PLEB666/Co2-Meter/docs/case_v4_back.png

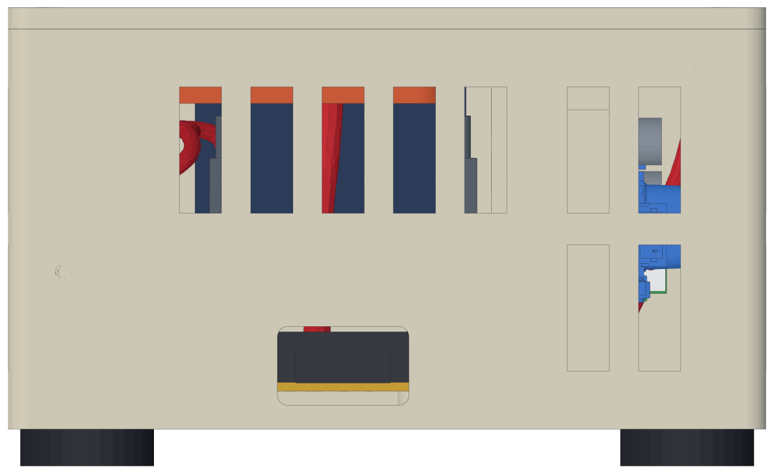
docs/case_v4_back.png
