PLEB666/Co2-Meter/docs/case_v4_back_open.png

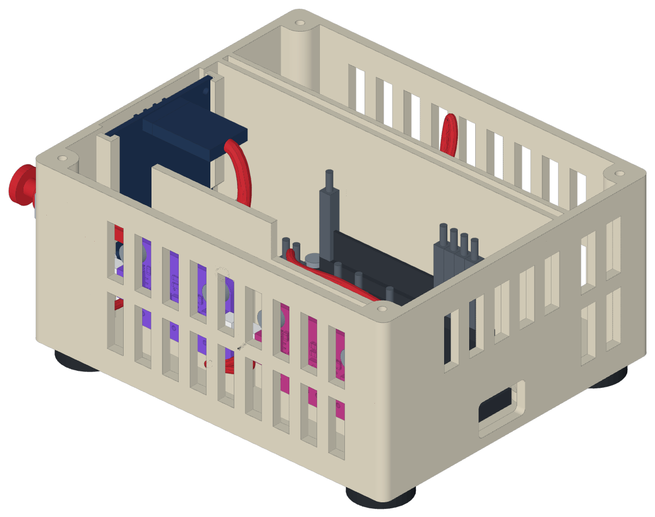
docs/case_v4_back_open.png
