PLEB666/Co2-Meter/docs/case_v4_cut.png

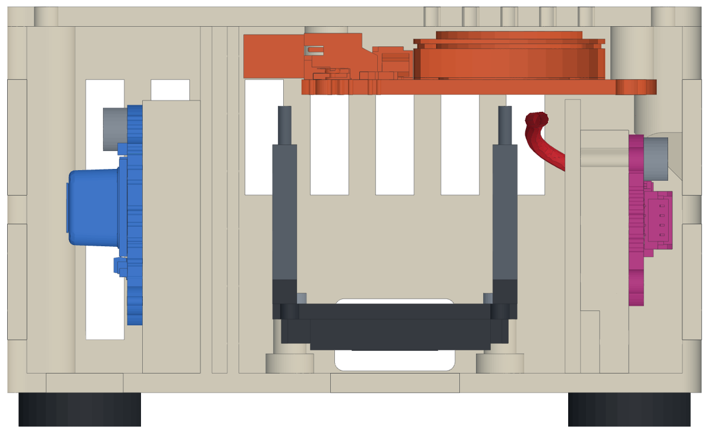
docs/case_v4_cut.png
