PLEB666/Co2-Meter/docs/case_v4_iso.png

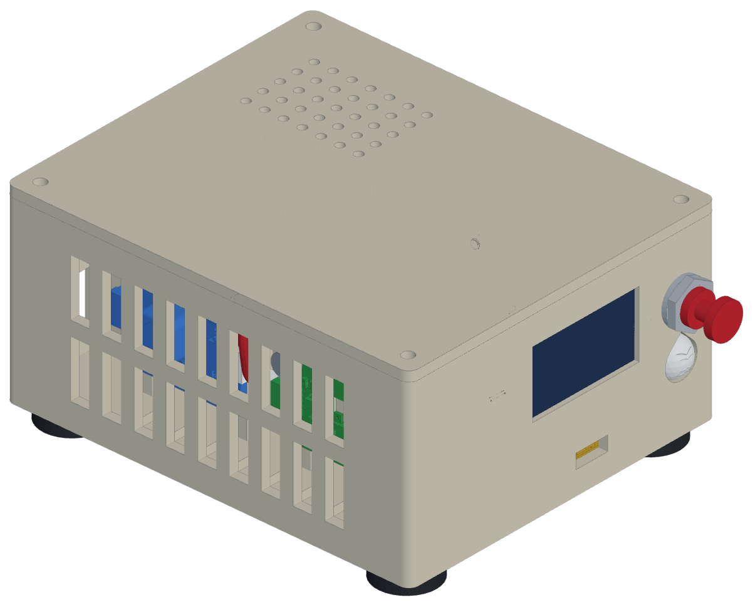
docs/case_v4_iso.png
