PLEB666/Co2-Meter/docs/case_v4_top.png

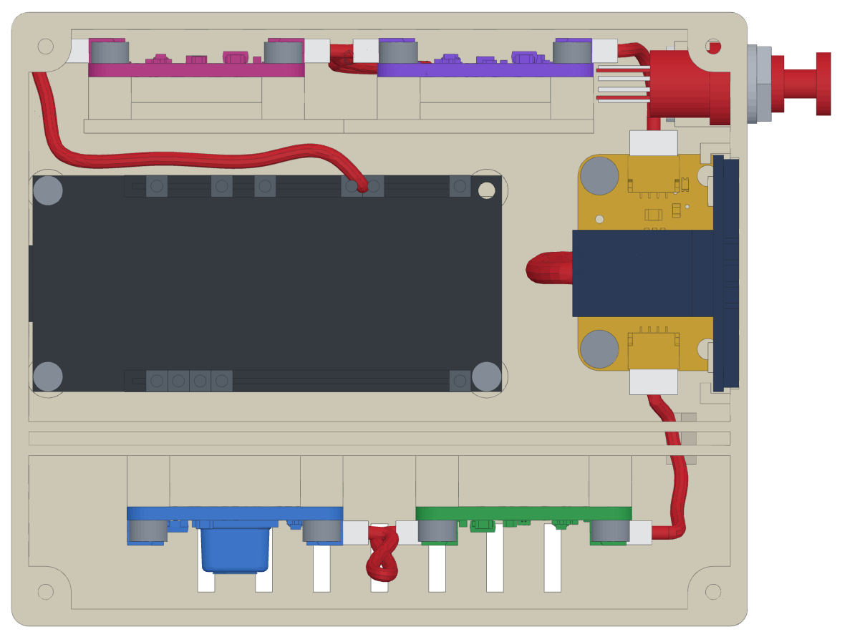
docs/case_v4_top.png
