PLEB666/Co2-Meter/docs/case_v5_front.png

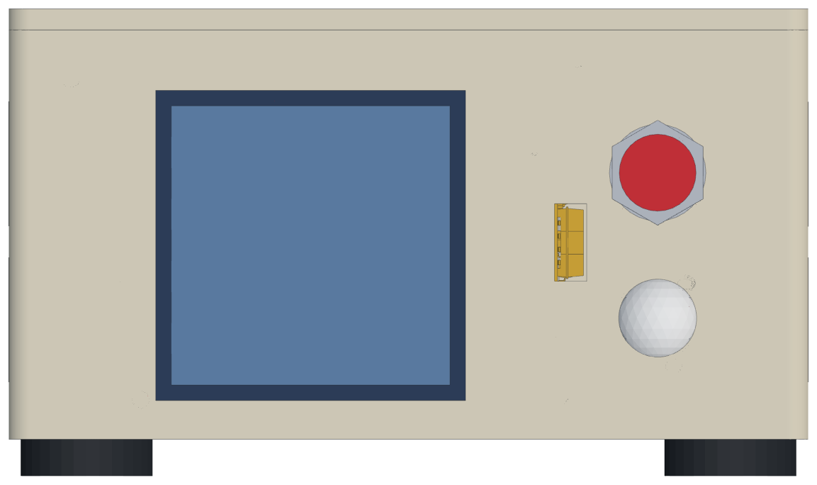
docs/case_v5_front.png
