PLEB666/Co2-Meter/docs/case_v5_iso.png

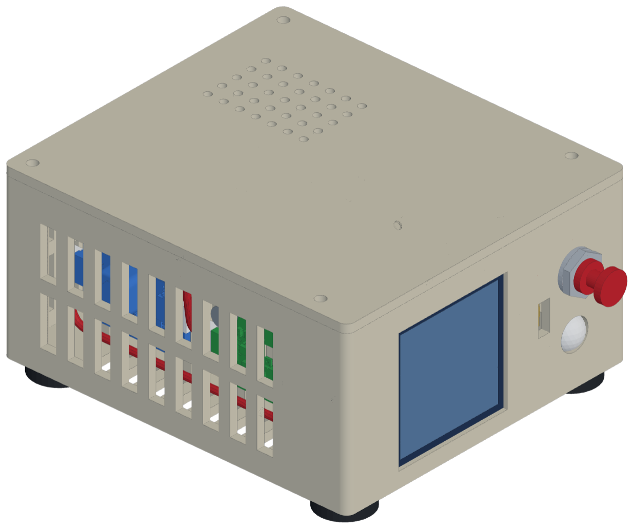
docs/case_v5_iso.png
