PLEB666/Co2-Meter/docs/web_page.png

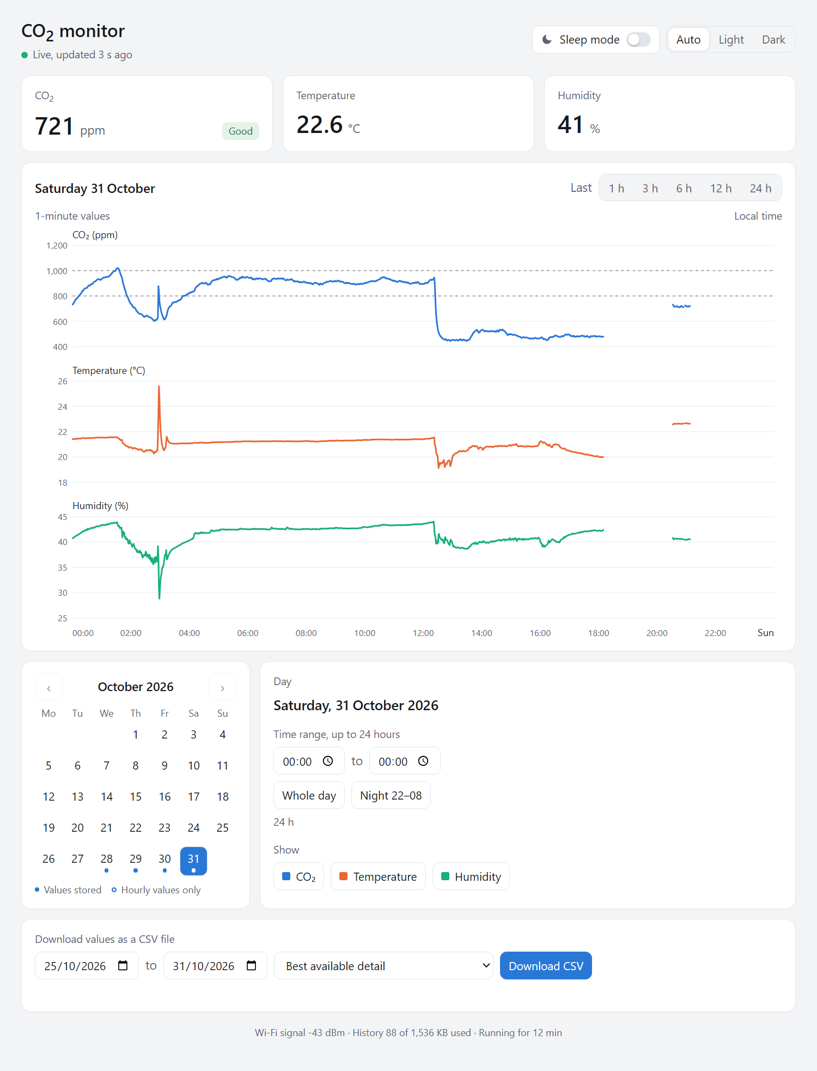
docs/web_page.png
