PLEB666/Co2-Meter/cad/adafruit/4829 SGP40 Sensor.step

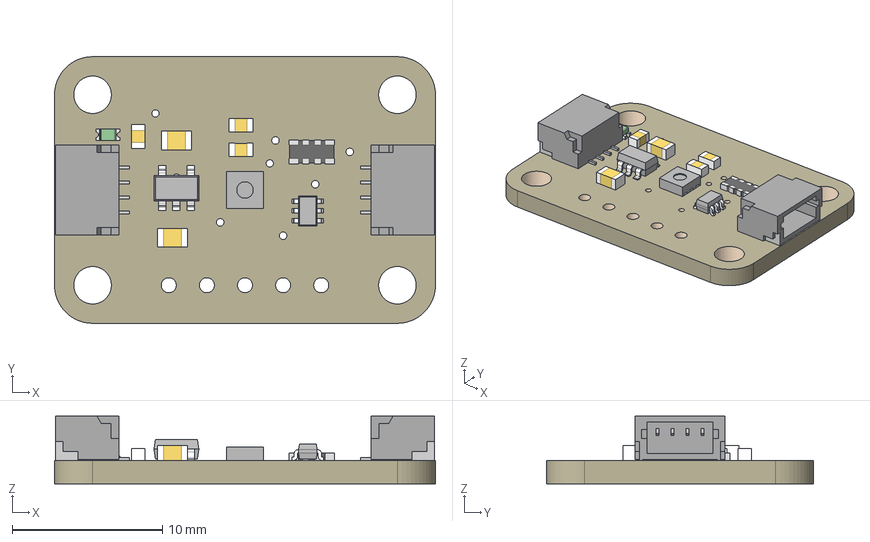
[picture p21: CAD file, 2026-11-03]
cad/adafruit/4829 SGP40 Sensor.step
25.4 x 17.8 x 4.53 mm
Board
SGP40
10uF x 2
AP2112-3.3K
4.7ohm x 3
10K
BSS138
STEMMA_I2C_QT x 2
Green
