PLEB666/Co2-Meter/cad/out/v5/esp32.stl

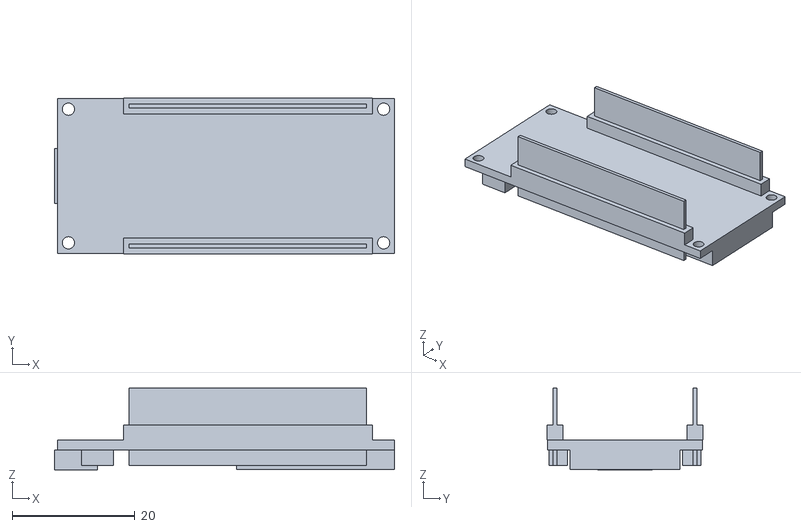
[picture p22: CAD file, 2026-11-07]
cad/out/v5/esp32.stl
55.5 x 25.4 x 13.4
