PLEB666/Co2-Meter/cad/out/v5/test_pieces/esp32_floor_no_drill.stl

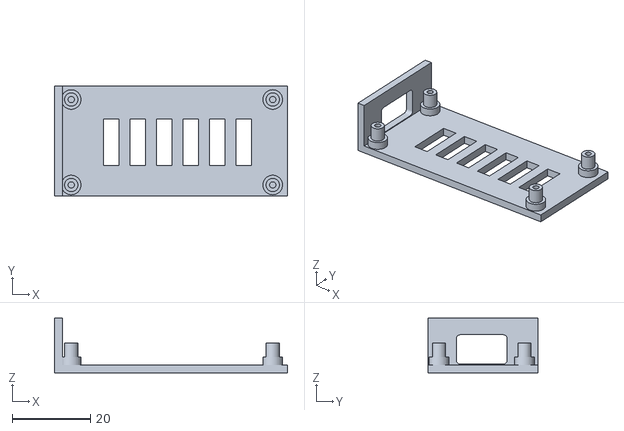
[picture p23: CAD file, 2026-11-07]
cad/out/v5/test_pieces/esp32_floor_no_drill.stl
59.5 x 28.0 x 14.0
