PLEB666/Co2-Meter/cad/adafruit/5187 SCD-40 C02 Sensor.step

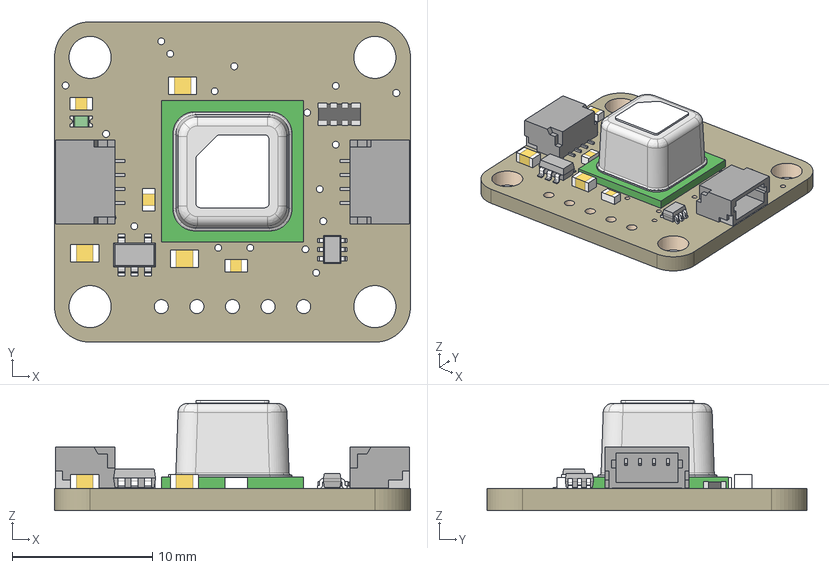
[picture p24: CAD file, 2026-11-01]
cad/adafruit/5187 SCD-40 C02 Sensor.step
25.4 x 22.9 x 7.88 mm
Board
10uF x 3
AP2112K-3.3
0.1uF x 3
10K
BSS138
STEMMA_I2C_QT x 2
GREEN
SCD-41
