PLEB666/Co2-Meter/cad/out/v5/lid.step

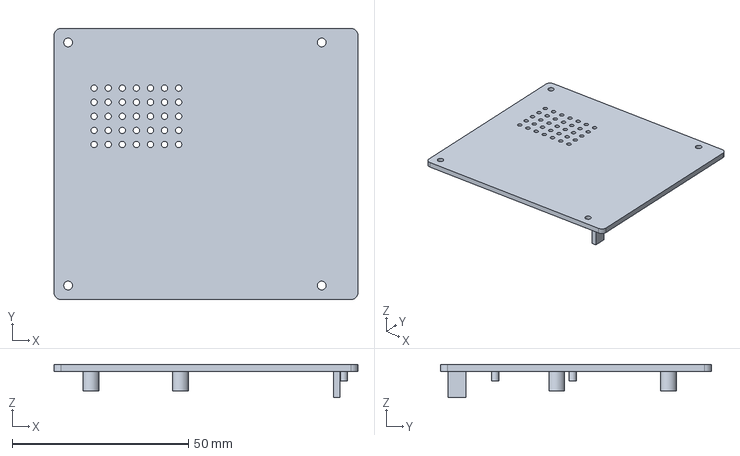
[picture p25: CAD file, 2026-11-07]
cad/out/v5/lid.step
86.3 x 77.0 x 9.44 mm
