PLEB666/Co2-Meter/cad/out/v5/test_pieces/esp32_floor.stl

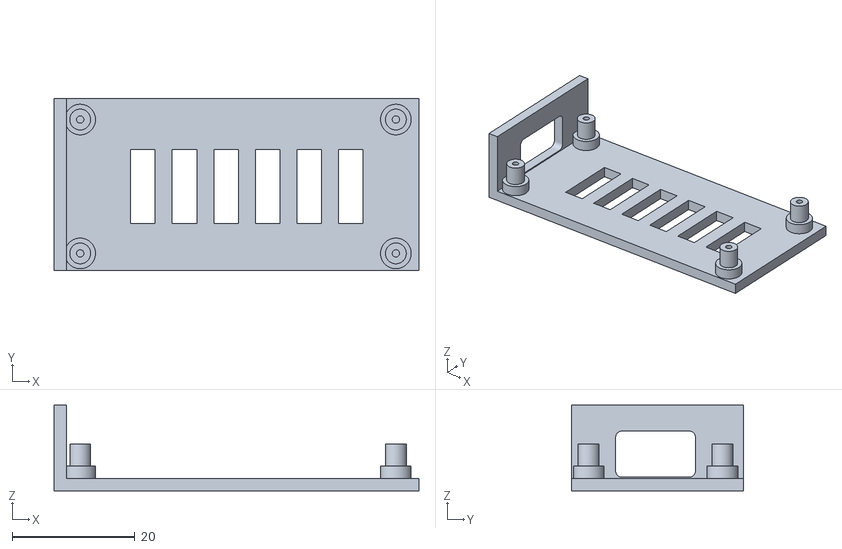
[picture p26: CAD file, 2026-11-07]
cad/out/v5/test_pieces/esp32_floor.stl
59.5 x 28.0 x 14.0
