PLEB666/Co2-Meter/cad/adafruit/5378 VEML7700 Lux Sensor.step

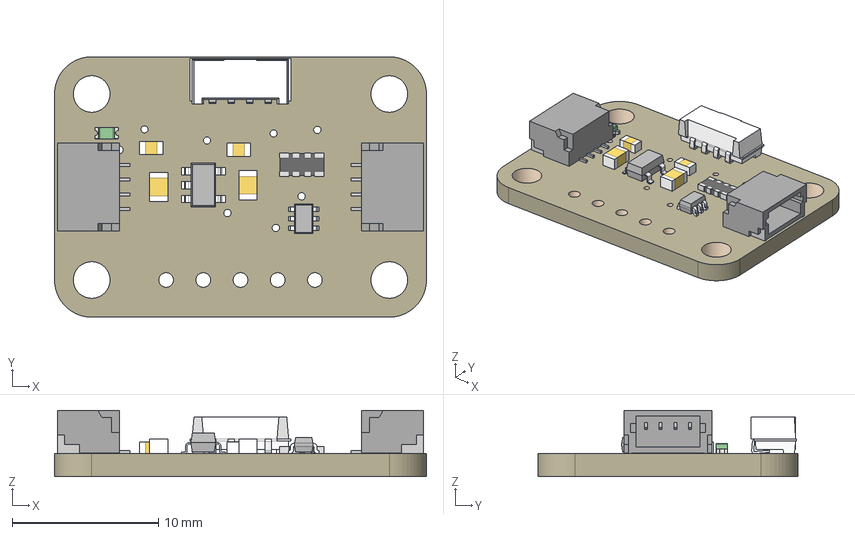
[picture p27: CAD file, 2026-11-01]
cad/adafruit/5378 VEML7700 Lux Sensor.step
25.4 x 17.8 x 4.53 mm
Board
10uF x 2
AP2112K-3.3
47K x 2
4.7K
BSS138
STEMMA_I2C_QT x 2
GREEN
VEML7700
