PLEB666/Co2-Meter/cad/out/v5/base.step

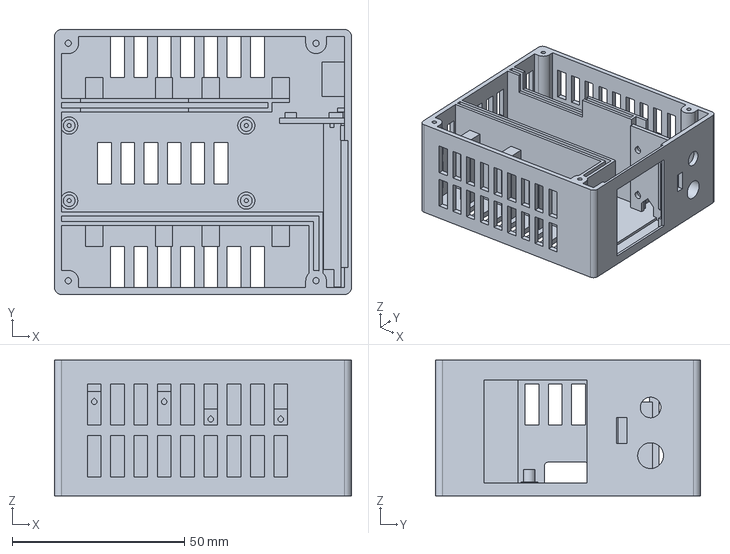
[picture p28: CAD file, 2026-11-07]
cad/out/v5/base.step
86.3 x 77.0 x 39.4 mm
