PLEB666/Co2-Meter/cad/out/v5/test_pieces/posts_sht45_no_drill.stl

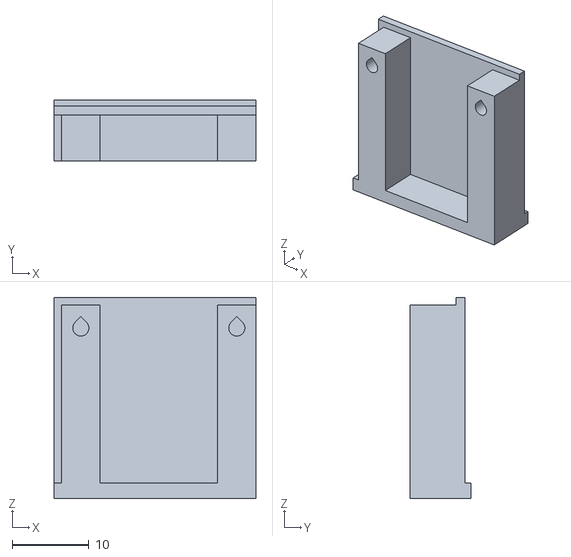
[picture p29: CAD file, 2026-11-06]
cad/out/v5/test_pieces/posts_sht45_no_drill.stl
26.3 x 8.00 x 26.2
