PLEB666/Co2-Meter/cad/adafruit/3885 STEMMA Speaker rev A.step

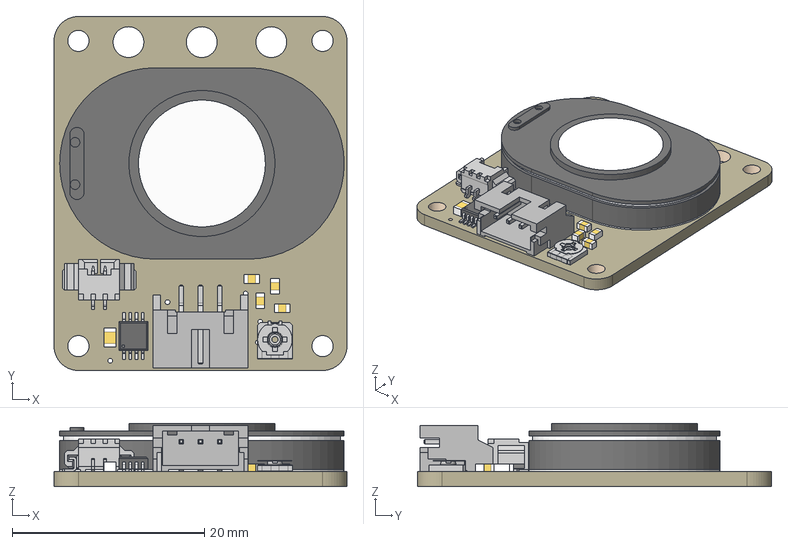
[picture p30: CAD file, 2026-11-01]
cad/adafruit/3885 STEMMA Speaker rev A.step
30.5 x 36.8 x 6.57 mm
Board
PAM8302AASCR
10uF
10K trim
CON_MOLEX_2P
SPEAKER_OVAL8OHM
JST PH 3
