PLEB666/Co2-Meter/cad/out/v5/button.stl

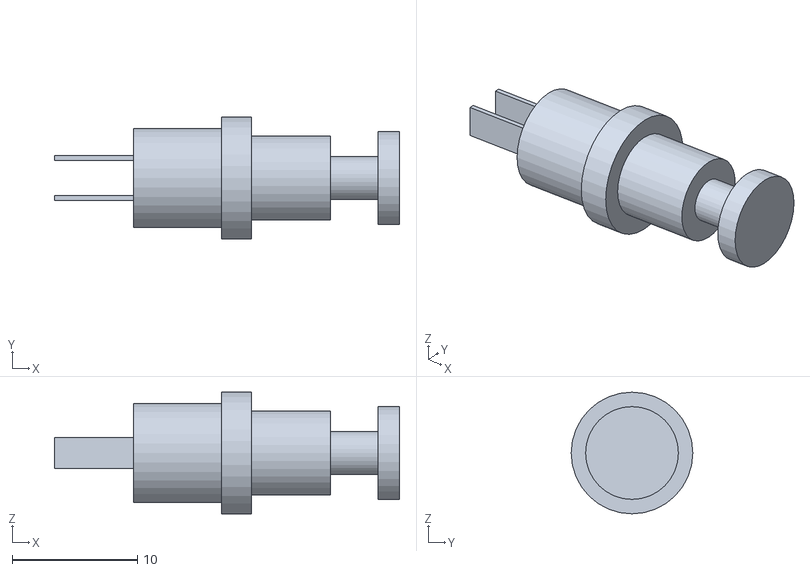
[picture p31: CAD file, 2026-11-06]
cad/out/v5/button.stl
27.5 x 9.70 x 9.70
