PLEB666/Co2-Meter/cad/out/v5/rubber_feet.stl

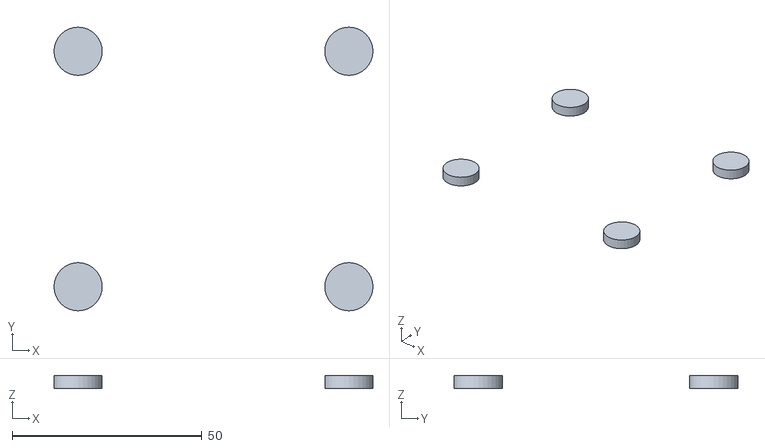
[picture p32: CAD file, 2026-11-06]
cad/out/v5/rubber_feet.stl
84.0 x 74.7 x 3.50
