PLEB666/Co2-Meter/cad/out/v5/oled_lit.stl

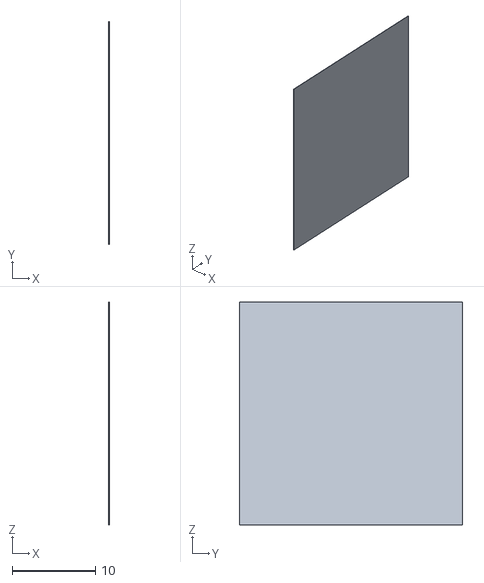
[picture p33: CAD file, 2026-11-06]
cad/out/v5/oled_lit.stl
0.05 x 26.9 x 26.9
