PLEB666/Co2-Meter/cad/out/v5/cables.stl

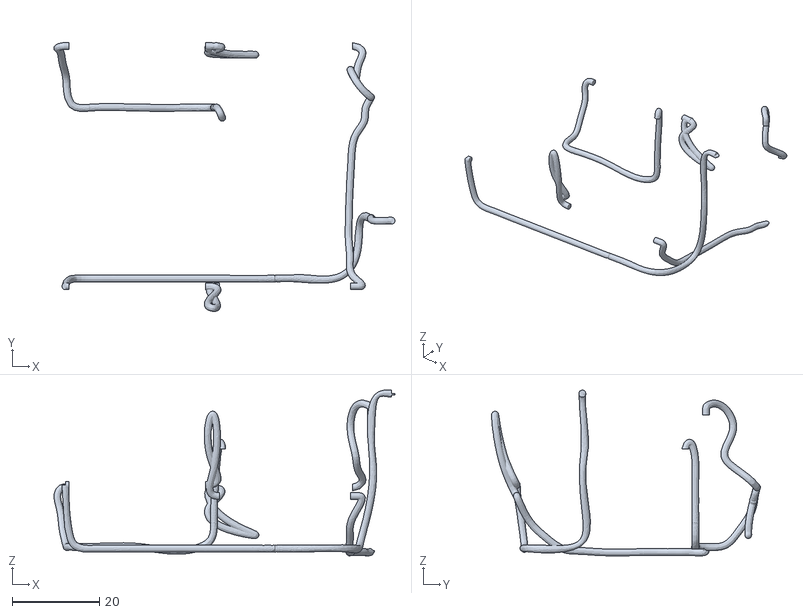
[picture p34: CAD file, 2026-11-06]
cad/out/v5/cables.stl
78.2 x 61.7 x 38.0
