PLEB666/Co2-Meter/cad/out/v5/oled.stl

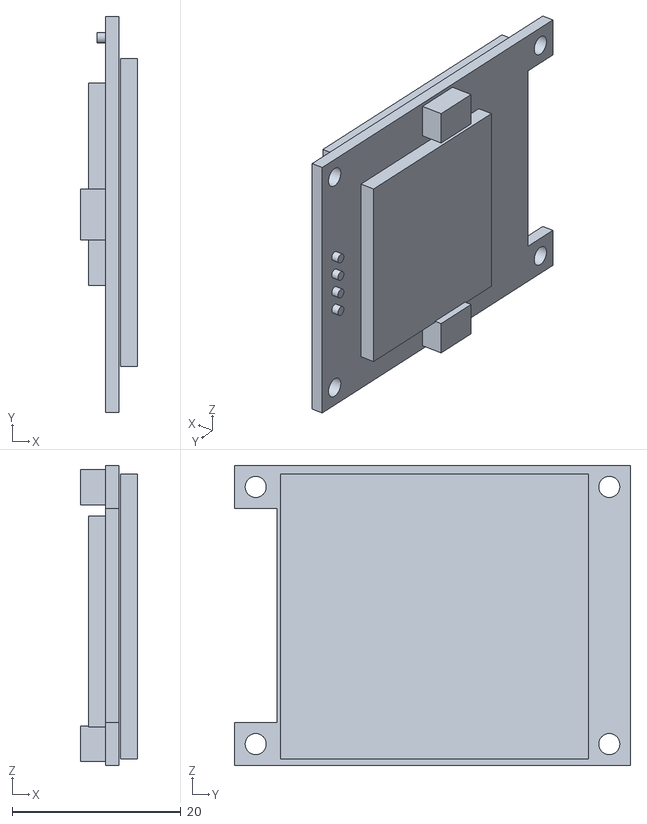
[picture p35: CAD file, 2026-11-06]
cad/out/v5/oled.stl
6.76 x 47.0 x 35.6
