PLEB666/Co2-Meter/cad/out/v5/esp32_plugs.stl

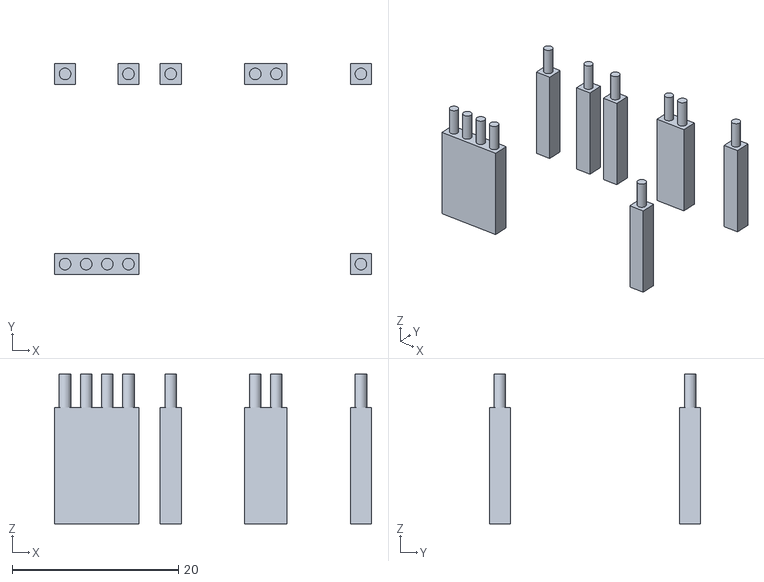
[picture p36: CAD file, 2026-11-06]
cad/out/v5/esp32_plugs.stl
38.1 x 25.4 x 18.0
