PLEB666/Co2-Meter/cad/out/v5/plugs.stl

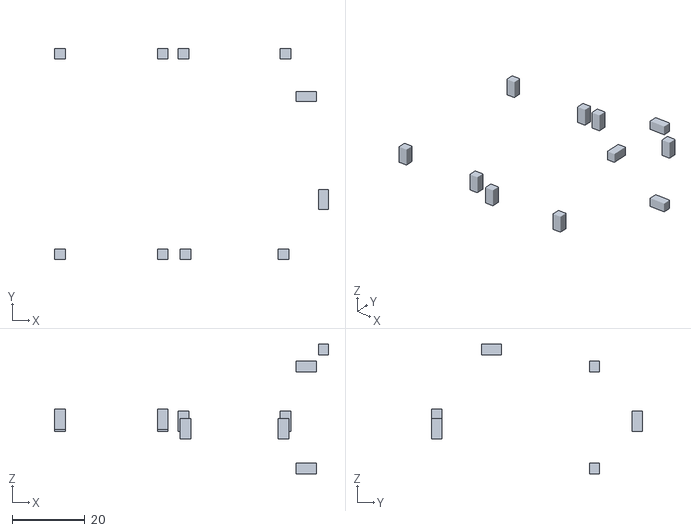
[picture p37: CAD file, 2026-11-06]
cad/out/v5/plugs.stl
75.4 x 57.9 x 35.7
