PLEB666/Co2-Meter/cad/out/v5/led.stl

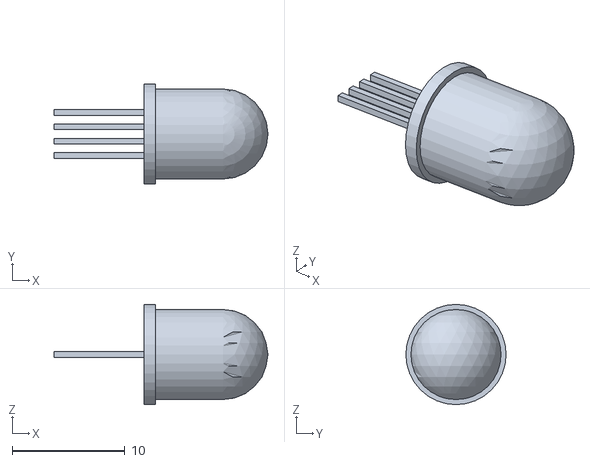
[picture p38: CAD file, 2026-11-06]
cad/out/v5/led.stl
19.0 x 8.90 x 8.90
