PLEB666/Co2-Meter/cad/out/v5/speaker.stl

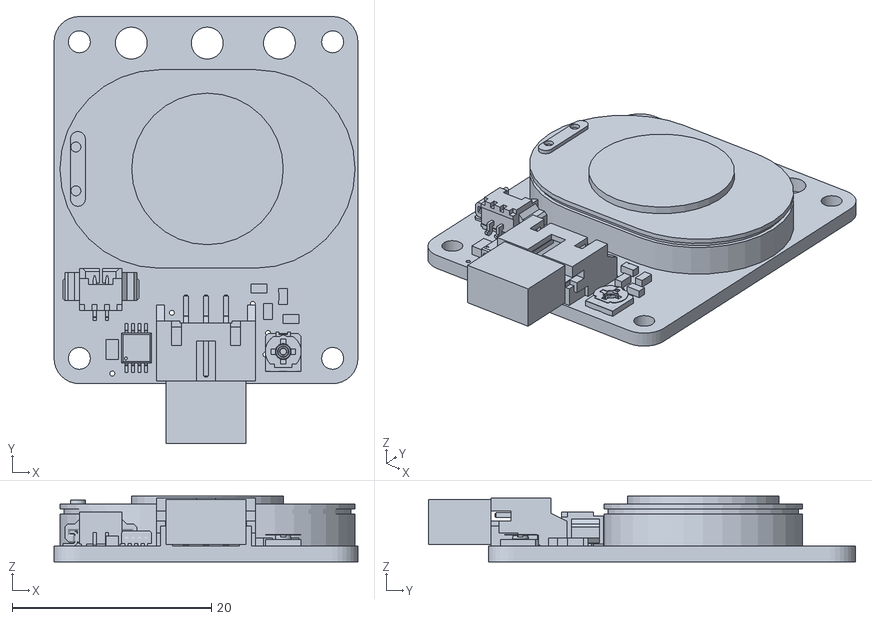
[picture p39: CAD file, 2026-11-06]
cad/out/v5/speaker.stl
30.5 x 42.8 x 6.57
