PLEB666/Co2-Meter/(list of files, cad)

Other CAD files:
cad/adafruit/5665 SHT45 Sensor.step
cad/out/v5/test_pieces/posts_sht45.stl
cad/adafruit/4816 BMP390 QT.step
cad/out/v5/scd41.stl
cad/out/v5/bmp580.stl
cad/out/v5/sht45.stl
cad/out/v5/sgp40.stl
cad/out/v5/veml7700.stl
cad/out/v5/base.stl
cad/out/v5/button_nut.stl
cad/out/v5/lid.stl
cad/out/v5/screws.stl
