PLEB666/Co2-Meter/firmware/co2_monitor/web_page.h

// Made by web/make_web_page.ps1 from web/index.html - change that file, not this one.
// The web page, gzip-compressed: 12640 bytes (37406 bytes uncompressed)
#pragma once

#include <Arduino.h>

const uint8_t WEB_PAGE[] PROGMEM = {
  0x1f, 0x8b, 0x08, 0x00, 0x00, 0x00, 0x00, 0x00, 0x04, 0x00, 0xad, 0x7d, 0x5b, 0x73, 0xe3, 0x46,
  0x92, 0xee, 0xbb, 0x23, 0xfc, 0x1f, 0xaa, 0xe9, 0xb6, 0x49, 0xb8, 0x49, 0x8a, 0xa4, 0x24, 0xb6,
  0x9a, 0x94, 0xd4, 0xeb, 0x6e, 0xb7, 0x2f, 0x67, 0x64, 0x7b, 0xa2, 0xbb, 0x3d, 0x9e, 0x39, 0x5a,
  0x85, 0x1b, 0x24, 0x40, 0x12, 0x16, 0x09, 0x70, 0x00, 0x50, 0x97, 0xe1, 0x32, 0xc2, 0xb1, 0x7f,
  0x61, 0x9f, 0xce, 0x1f, 0xd8, 0xe7, 0xf3, 0x76, 0xe2, 0x9c, 0xc7, 0xfd, 0x29, 0xfe, 0x25, 0x27,
  0xbf, 0xac, 0x0b, 0xaa, 0x00, 0xe8, 0x62, 0xef, 0xf8, 0x22, 0x12, 0x85, 0xaa, 0xac, 0xac, 0xac,
  0xcc, 0xac, 0xcc, 0xac, 0xac, 0xe2, 0xf1, 0x93, 0x20, 0x99, 0xe6, 0xb7, 0xeb, 0x50, 0x2c, 0xf2,
  0xd5, 0xf2, 0xf4, 0xe3, 0x8f, 0x8e, 0x9f, 0x74, 0x3a, 0x1f, 0x7f, 0x24, 0xc4, 0xeb, 0x1f, 0x06,
  0x62, 0x95, 0xc4, 0x51, 0x9e, 0xa4, 0xe2, 0x3a, 0x9c, 0x88, 0xb5, 0x3f, 0x0f, 0xbb, 0xe2, 0xfd,
  0x22, 0x14, 0xb3, 0x28, 0x5d, 0x5d, 0xfb, 0x69, 0x28, 0xb2, 0x30, 0xbd, 0x0a, 0x33, 0xe1, 0x8b,
  0x69, 0xb2, 0x5a, 0xa7, 0x61, 0x96, 0x85, 0x01, 0x7d, 0x5d, 0xdf, 0x8a, 0x16, 0x35, 0xf8, 0x99,
  0x1b, 0x2c, 0xbc, 0x2e, 0x80, 0x7d, 0x31, 0xcb, 0xc3, 0x54, 0x4c, 0x17, 0x7e, 0x3c, 0x8f, 0xe2,
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
  0xd1, 0x77, 0x61, 0x10, 0xf9, 0xad, 0x66, 0x8b, 0x64, 0x62, 0x16, 0xa6, 0x59, 0xc7, 0x9e, 0x9e,
  0x11, 0x83, 0xf7, 0x9a, 0x5e, 0x97, 0xab, 0x86, 0x99, 0x37, 0x46, 0xbf, 0x24, 0x84, 0x9b, 0x15,
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
};
