PLEB666/Co2-Meter/firmware/co2_monitor/secrets_example.h

// Template for secrets.h. Copy this file to secrets.h (same folder) and enter
// your Wi-Fi network there. secrets.h is listed in .gitignore and never committed.
// The ESP32-C6 only uses 2.4 GHz Wi-Fi.
#pragma once

constexpr char WIFI_SSID[] = "your-wifi-name";
constexpr char WIFI_PASSWORD[] = "your-wifi-password";
