PLEB666/Co2-Meter/(commit log)

2026-10-29 Add history storage, 30 s warm-up and web page
    - History: values are stored with LittleFS on the 1.5 MB data partition
    as 1-minute (7 days), 5-minute (90 days) and hourly avg/min/max values,
    saved every 10 minutes. Wi-Fi and internet time (UTC); the Wi-Fi
    details go in secrets.h, which is gitignored (template:
    secrets_example.h). Serial commands: status, files, csv, save.
    - Warm-up: for 30 s after start-up nothing is shown, printed or saved;
    the display counts down.
    - Web page served by the monitor: live values, graphs of CO2,
    temperature and humidity for any stored day or the last 1-24 h,
    calendar marks on days with data, CSV download between two dates,
    and Auto/Light/Dark t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
2026-10-31 Add sleep mode for the night
    - Sleep mode switches the RGB LED off and shows a small moon in the
    top line of the display. The sensors, the history and the web page
    keep running. The setting is kept in NVS (Preferences), so it
    survives a restart.
    - Turned on and off by holding the button for 2 s (LONG_PRESS_MS; the
    display confirms the new mode for SLEEP_MESSAGE_MS), by a switch on
    the web page (POST /api/sleep?on=1|0, state in /api/now), or with
    "sleep on|off" in the Serial Monitor. "status" shows it.
    - Docs v0.12: sleep mode in section 6, test step 10, troubleshooting
    rows, and the power LEDs that software can't switch off, with
    Figure 7 showing where tape may cover the SCD-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
2026-10-31 Docs v0.13: screwed sensor mounts, screwdriver slots, open case points
    Section 13: the sensor boards are screwed with M2.5 x 6 hex socket
    screws to standoffs on the double wall instead of held by clips. The
    chamber's side vents become 4 mm vertical slots so a 2 mm hex
    screwdriver reaches the screws from outside, with a removable dust mesh
    behind them. Adds the boards' mounting holes, Figure 12, the BMP580 as
    the in-stock pressure sensor, and notes on what is still open (sensor
    layout and 50 mm cables, mesh size, light sensor).
2026-11-01 Docs v0.14: case measurement sheet, board models, ESP32 one row over
    - Section 13: the old list of needed sizes is now a measurement sheet
    with 28 IDs (breadboard, ESP32, wires, OLED, sensor boards, case
    parts, speaker), a "so far" column and the first measured values.
    New Figure 13 shows where each value is measured.
    - Adafruit's STEP models of the SCD-40, SHT45, BMP390, right-angle
    VEML7700 and STEMMA speaker boards in cad/adafruit/ (MIT licence).
    The sensor-board table and a new list give heights, sensor and
    socket sizes read from them (boards 1.57 mm, SCD-41 sensor 6.3 mm
    above the board, STEMMA QT sockets 6.0 x 4.95 x 3.0 mm).
    - OLED glass, lit area, holes and flex strip r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
    [3885 STEMMA Speaker rev A.step, 4816 BMP390 QT.step, 5187 SCD-40 C02 Sensor.step, 5378 VEML7700 Lux Sensor.step, 5665 SHT45 Sensor.step]
2026-11-02 Docs v0.19: build123d case model, printing at school, sensor layout
    - cad/case.py: printable base and lid as STEP files (build123d 0.13.0),
    with a browser viewer template and a launch config to serve it
    - Docs: school printer (Stratasys F370, ABS/ASA, STEP, pilot holes to
    drill), all three air sensors on base standoffs, light sensor under
    the OLED, display and speaker holders, fewer vents, screws and feet
    - .gitignore: CAD venv and generated output
2026-11-03 Docs v0.20: compact case v4 and its 3D model
    - New build123d model cad/case_v4.py (writes cad/out/v4/): 86.3 x 72 x 40 mm
    instead of 105 x 86 x 40, same look, no breadboard. Waveshare
    ESP32-C6-DEV-KIT-N16 upside down on 4 posts, chamber with SCD-41 and SHT45
    only, a walled column-j compartment with the BMP580 and room for an SGP40,
    light sensor on screwed posts, Berrybase 10130 panel button, PL9823-F8 LED
    in a sleeve, speaker under the lid. Checks: no clashes, all 8 side-slot
    screws reachable, cable lengths. cad/case.py keeps v3.
    - Adafruit's SGP40 STEP model added to cad/adafruit/.
    - Viewer: new address options isoBack and clean (pictures for the docs).
    - Docs section 13 rewritt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
    [4829 SGP40 Sensor.step]
2026-11-04 Docs v0.21: case v5 with the 1.5" OLED and its 3D model
    - New build123d model cad/case_v5.py (writes cad/out/v5/): 86.3 x 77 x 41.43 mm
    with the Adafruit 4741 1.5" 128x128 OLED turned 90 degrees, standing in a
    floor groove with its glass in a front-wall recess and held by 2 hidden
    M2.5 x 4 screws at its header end. A double cross wall behind it closes the
    sensor chamber. cad/case_v4.py keeps v4.
    - The SGP40/BMP580 compartment is 18 mm deep like the chamber (case 5 mm
    wider), with its own double wall and air gap closed at both ends. Both
    sensor bays share posts, side slots, 4 back slots and 7 floor vents; all
    vents are 4 x 12 mm slots. All 4 lid bosses stand on the floor.
    - VEML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
2026-11-05 Docs v0.22: case hardware with order status, prototyping chapter
    - The docs now cover only the hardware that goes into the case. Section 2
    lists every case part as have, ordered or to buy (new status chips); the
    parts table in section 13 has the same status column.
    - Section 3 shows the Waveshare ESP32-C6-DEV-KIT-N16 and the pins used in the
    case (moved from section 13), with which ones the firmware already uses.
    Figure 1 now shows the STEMMA QT chain in the case.
    - Section 4 is a short Prototyping chapter instead of the breadboard wiring.
    The breadboard layout (old Figure 3) and the measurement sketch (old
    Figure 14) are gone; figures renumbered 1 to 12.
    - Removed the DevKitC-1,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
2026-11-06 Docs v0.23: keep the case v5 viewer and print files in git
    cad/out/v5/ (viewer.html, base/lid STEP, STL of every part) is no
    longer ignored, so the 3D viewer and the files for the printer come
    with a clone without running case_v5.py. Older output folders stay
    ignored.
    [base.step, base.stl, bmp580.stl, button.stl, button_nut.stl, cables.stl, esp32.stl, esp32_plugs.stl]
2026-11-06 Docs v0.25: small test pieces; v0.24: all 4 ESP32 posts the same
    v0.25: new cad/test_pieces_v5.py cuts small test pieces out of the v5
    base into cad/out/v5/test_pieces/: the ESP32 floor (back wall with the
    USB-C opening, floor, 4 posts) and the SHT45's two posts, which stand for
    all sensor boards (same hole spacing). Each piece also comes as a
    no-drill version with the screw holes at their drilled size. Printing at
    school lists what each piece checks; sections 1 and 13 updated.
    v0.24: the 4th ESP32 post is round with a pilot hole and an M2 screw like
    the other three; the module is drawn 18.0 mm wide (data sheet), centred.
    Rebuilt cad/out/v5, Figure 8 re-shot.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
    [base.step, base.stl, esp32.stl, esp32_floor.stl, esp32_floor_no_drill.stl, lid.step, posts_sht45.stl, posts_sht45_no_drill.stl]
2026-11-07 Docs v0.26: USB-C opening 13.0 x 7.5, sized to the cables
    The USB-C opening in case v5 is now 13.0 x 7.5 mm (was 12.5 x 7.5),
    from the plug grips of the four cables (Ugreen 11.10 x 6.50, Toocki
    11.00 x 6.50, Nintendo 11.65 x 6.50, Samsung 12.00 x 6.00): at least
    0.5 mm on each side of each grip. 7.5 is the most it can be, since its
    bottom edge is 0.22 mm above the floor.
    Waveshare board measured again on Waveshare's dimension drawing and
    Berrybase's top-view photo: board, holes and pin rows match the model
    to about 0.1 mm, module and USB-C port are centred. The USB-C port
    sticks out about 0.5 mm (was 0.8), so its face is flush with the inside
    of the back wall; RESET and BOOT moved to the lo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
    [base.step, base.stl, esp32.stl, esp32_floor.stl, esp32_floor_no_drill.stl, lid.step]
